ThLehmann/XSensor/PCB/XSensAdapt/Variants/ProMini3Pin2.png

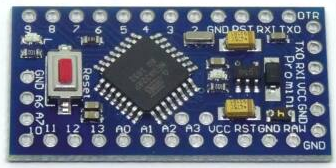
PCB/XSensAdapt/Variants/ProMini3Pin2.png
