ThLehmann/XSensor/PCB/XSensAdapt/Variants/ProMini3Pin.png

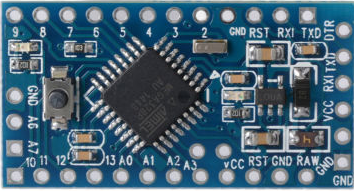
PCB/XSensAdapt/Variants/ProMini3Pin.png
