ThLehmann/XSensor/PCB/XSensAdapt/Variants/ProMini0Pin2.png

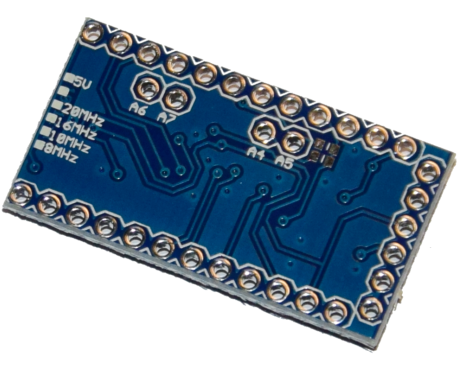
PCB/XSensAdapt/Variants/ProMini0Pin2.png
