ThLehmann/XSensor/PCB/XSensAdapt/Variants/ProMini0Pin.png

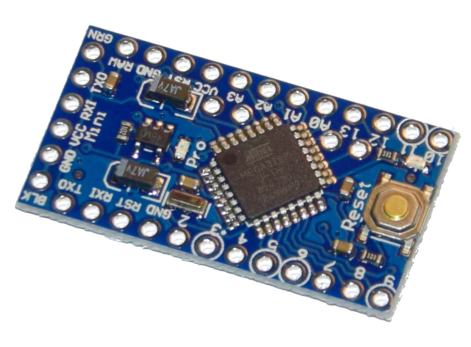
PCB/XSensAdapt/Variants/ProMini0Pin.png
