ThLehmann/XSensor/PCB/XSensAdapt/Variants/ProMini5Pin.png

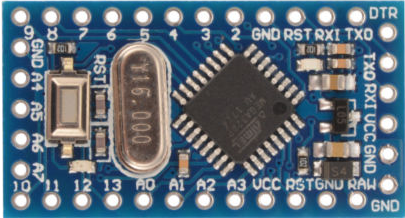
PCB/XSensAdapt/Variants/ProMini5Pin.png
