ThLehmann/XSensor/PCB/MUL-6S/MUL-6S.brd

## EAGLE design PCB/MUL-6S/MUL-6S.brd (2020-03-09)

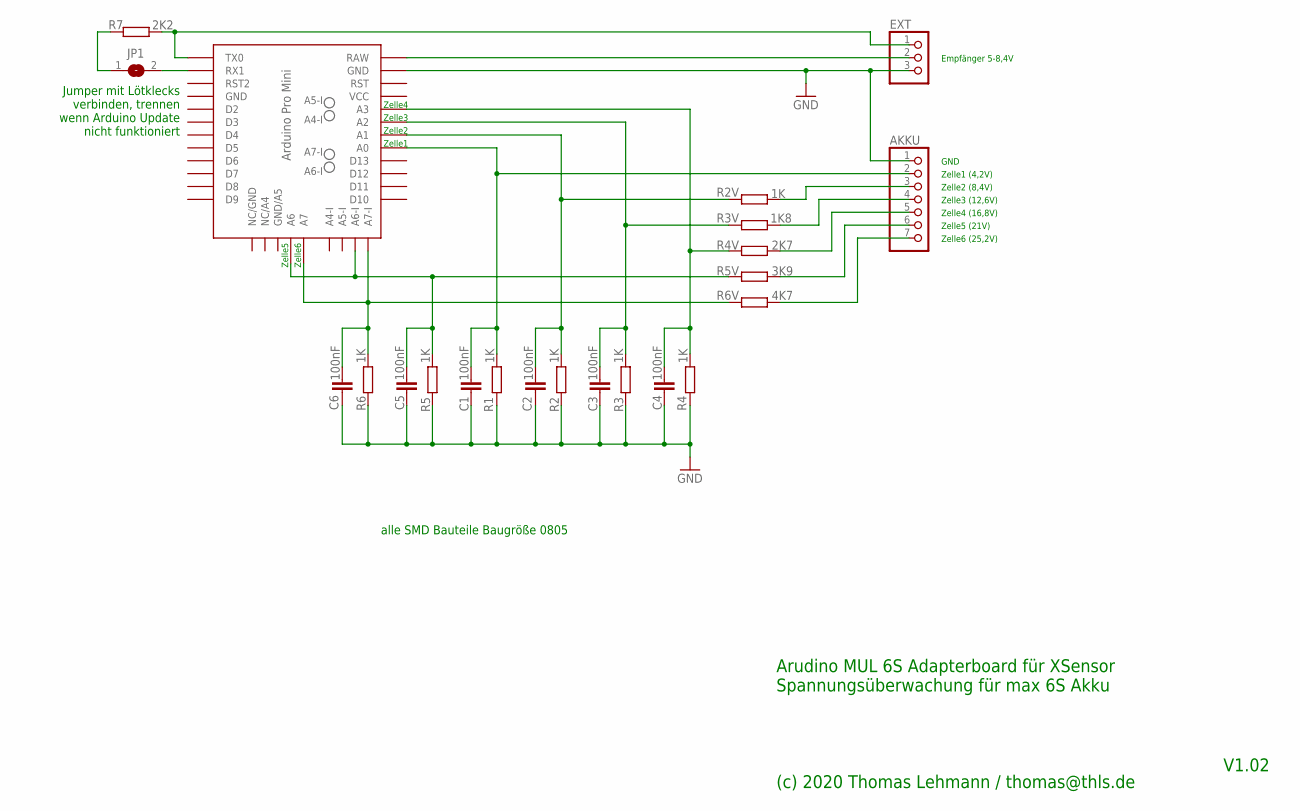
[picture p82: schematic MUL-6S.sch]

Parts:
AKKU: 1X07/90
C1, C2, C3, C4, C5, C6: 100nF; C0805K
EXT: 1X03/90
JP1: SJ
R1, R2, R2V, R3, R4, R5, R6: 1K; R0805
R3V: 1K8; R0805
R4V: 2K7; R0805
R5V: 3K9; R0805
R6V: 4K7; R0805
R7: 2K2; R0805
U$1: PRO-MINI-5PIN-KLPAD

Connections:
GND: AKKU.1, C1.2, C2.2, C3.2, C4.2, C5.2, C6.2, EXT.3, R1.2, R2.2, R3.2, R4.2, R5.2, R6.2, U$1.GND, U$1.GND1 (GND)
unnamed: C4.1, R4.1, R4V.1, U$1.A3
unnamed: EXT.2, U$1.RAW
unnamed: EXT.1, R7.2, U$1.TX0
unnamed: JP1.1, R7.1
unnamed: AKKU.3, R2V.2
unnamed: AKKU.4, R3V.2
unnamed: AKKU.5, R4V.2
unnamed: AKKU.6, R5V.2
unnamed: AKKU.7, R6V.2
unnamed: AKKU.2, C1.1, R1.1, U$1.A0
unnamed: C5.1, R5.1, R5V.1, U$1.A6, U$1.A6-I
unnamed: C6.1, R6.1, R6V.1, U$1.A7, U$1.A7-I
unnamed: JP1.2, U$1.RX1
unnamed: C2.1, R2.1, R2V.1, U$1.A1
unnamed: C3.1, R3.1, R3V.1, U$1.A2

Notes on the sheet:
Zelle1
Zelle2
Zelle3
Zelle4
Zelle5
Zelle6
Zelle1 (4,2V)
Zelle2 (8,4V)
Zelle3 (12,6V)
Zelle4 (16,8V)
Zelle5 (21V)
Zelle6 (25,2V)
GND
Empfänger 5-8,4V
Arudino MUL 6S Adapterboard für XSensor Spannungsüberwachung für max 6S Akku
(c) 2020 Thomas Lehmann / thomas@thls.de
V1.02
Jumper mit Lötklecks verbinden, trennen wenn Arduino Update nicht funktioniert
alle SMD Bauteile Baugröße 0805

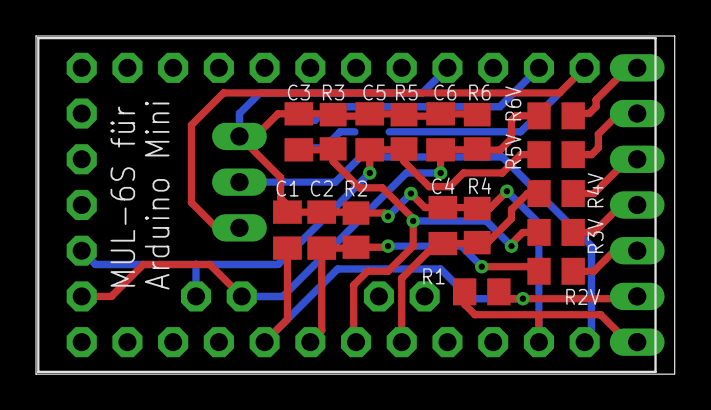
[picture p83: board MUL-6S.brd from above]

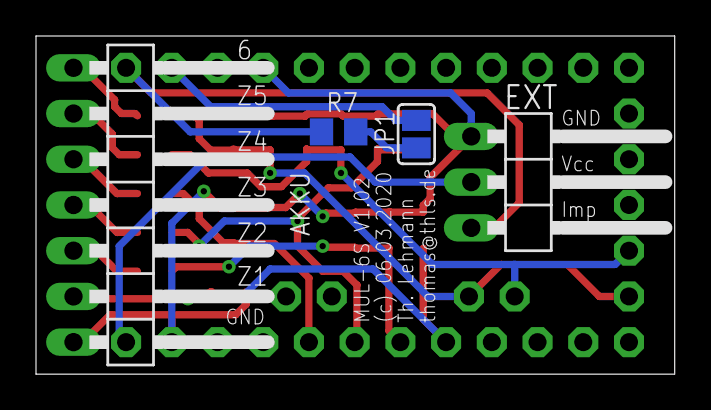
[picture p84: board MUL-6S.brd from below]

Board: 2 copper layers, 35.5 x 18.8 mm, 22 parts (2 on the bottom side), 16 nets.
