ThLehmann/XSensor/PCB/XSensAdapt/XSensorAdapter.brd

## EAGLE design PCB/XSensAdapt/XSensorAdapter.brd (2020-01-29)

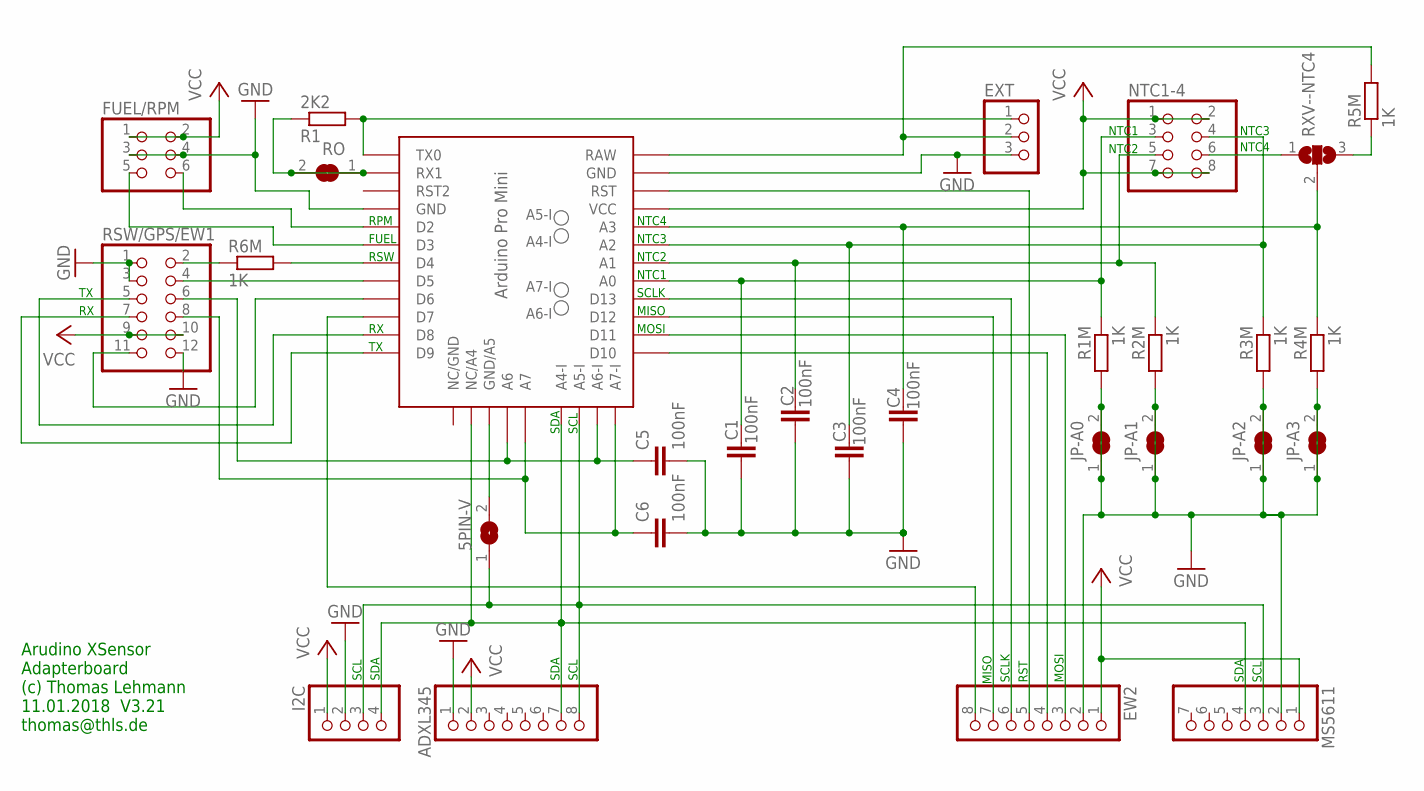
[picture p85: schematic XSensorAdapter.sch]

Parts:
5PIN-V: SJ
ADXL345: 1X08
C1, C2, C3, C4, C5, C6: 100nF; C2.5-2
EW2: 1X08
EXT: 1X03
FUEL/RPM: 2X03
I2C: 1X04
JP-A0, JP-A1, JP-A2, JP-A3: SJ
MS5611: 1X07
NTC1-4: 2X04
R1: 2K2; 0207/10
R1M, R2M, R3M, R4M, R5M, R6M: 1K; 0207/10
RO: SJ
RSW/GPS/EW1: 2X06
RXV--NTC4: SJ_2
U$1: PRO-MINI-5PINPRO-MINI-5PIN; PRO-MINI-5PIN

Connections:
GND: ADXL345.1, C1.2, C2.2, C3.2, C4.2, C5.2, C6.2, EW2.2, EXT.3, FUEL/RPM.3, FUEL/RPM.4, I2C.2, JP-A0.1, JP-A0.2, JP-A1.1, JP-A1.2, JP-A2.1, JP-A2.2, JP-A3.1, JP-A3.2, MS5611.2, R1M.2, R2M.2, R3M.2, R4M.2, RSW/GPS/EW1.1, RSW/GPS/EW1.3, RSW/GPS/EW1.12, U$1.GND, U$1.GND1 (GND)
unnamed: C4.1, R4M.1, RXV--NTC4.2, U$1.A3
unnamed: EXT.1, R1.2, U$1.TX0
unnamed: RSW/GPS/EW1.7, U$1.D9
unnamed: R5M.1, RXV--NTC4.3
unnamed: C5.1, RSW/GPS/EW1.6, U$1.A6, U$1.A6-I
unnamed: RSW/GPS/EW1.4, U$1.D5
unnamed: RSW/GPS/EW1.5, U$1.D8
unnamed: 5PIN-V.2, U$1.GND/A5
unnamed: C1.1, NTC1-4.3, R1M.1, U$1.A0
unnamed: FUEL/RPM.6, U$1.D2
unnamed: R6M.2, U$1.D4
unnamed: ADXL345.7, I2C.4, MS5611.4, U$1.A4-I, U$1.NC/A4
unnamed: FUEL/RPM.5, U$1.D3
unnamed: R6M.1, RSW/GPS/EW1.2
unnamed: C6.1, RSW/GPS/EW1.8, U$1.A7, U$1.A7-I
unnamed: C2.1, NTC1-4.5, R2M.1, U$1.A1
unnamed: C3.1, NTC1-4.4, R3M.1, U$1.A2
unnamed: EW2.6, U$1.D13
unnamed: EW2.7, U$1.D12
unnamed: EW2.3, U$1.D11
unnamed: EW2.4, U$1.D10
unnamed: EXT.2, R5M.2, U$1.RAW
unnamed: RSW/GPS/EW1.11, U$1.D6
unnamed: NTC1-4.6, RXV--NTC4.1
unnamed: EW2.5, U$1.RST
unnamed: EW2.8, U$1.D7
unnamed: 5PIN-V.1, ADXL345.8, I2C.3, MS5611.3, U$1.A5-I
unnamed: R1.1, RO.1, RO.2, U$1.RX1
VCC: ADXL345.2, EW2.1, FUEL/RPM.1, FUEL/RPM.2, I2C.1, MS5611.1, NTC1-4.1, NTC1-4.2, NTC1-4.7, NTC1-4.8, RSW/GPS/EW1.9, RSW/GPS/EW1.10, U$1.VCC

Notes on the sheet:
Arudino XSensor Adapterboard (c) Thomas Lehmann 11.01.2018 V3.21 thomas@thls.de
SDA
SCL
MOSI
MISO
SCLK
NTC1
NTC2
NTC3
NTC4
RPM
FUEL
RSW
RST

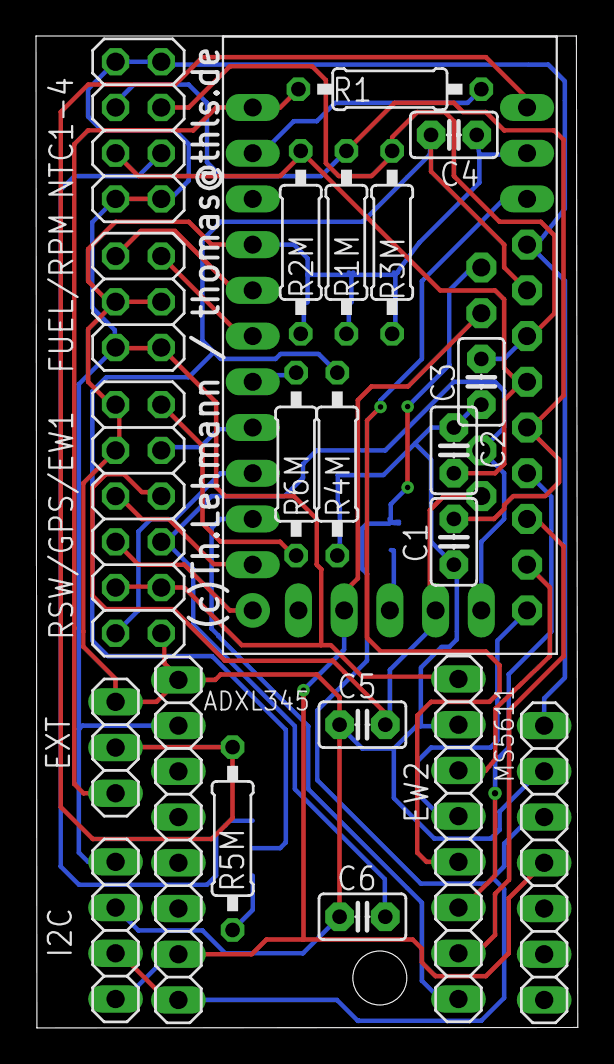
[picture p86: board XSensorAdapter.brd from above]

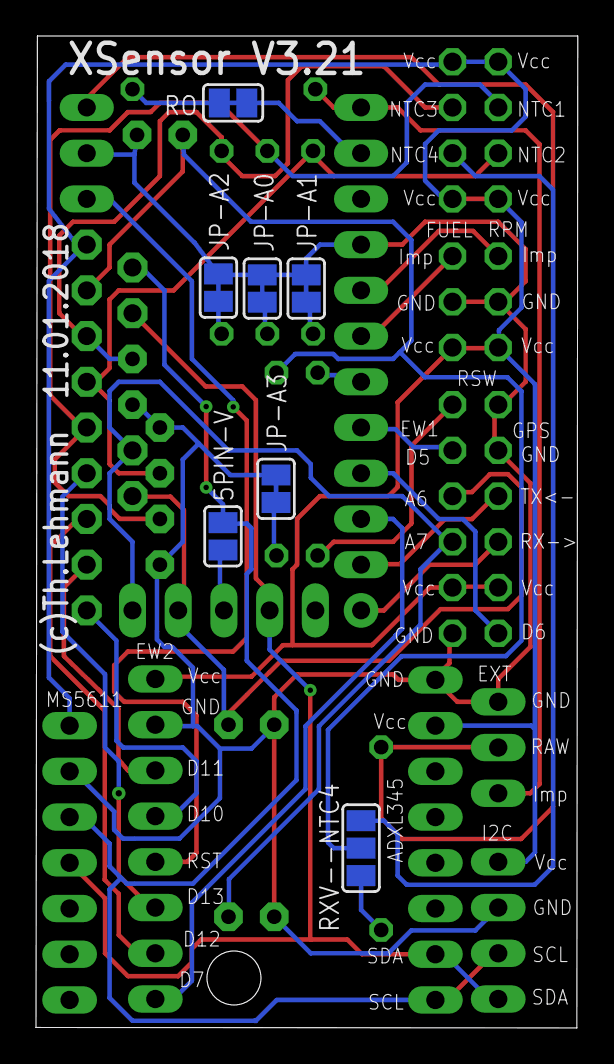
[picture p87: board XSensorAdapter.brd from below]

Board: 2 copper layers, 30.1 x 55.1 mm, 29 parts (7 on the bottom side), 30 nets.
