ThLehmann/XSensor/XSensor/JetiExProtocol.h

/* 
  Jeti Sensor EX Telemetry C++ Library
  
  JetiExProtocol - EX protocol implementation
  --------------------------------------------------------------------
  
  Copyright (C) 2015 Bernd Wokoeck
  
  Version history:
  0.90   11/22/2015  created
  0.95   12/23/2015  Refactoring
  0.96   02/21/2016  comPort number as parameter for Teensy
                     sensor device id as optional parameter (SetDeviceId())
  0.99   06/05/2016  increase max number of sensors to 32
  1.00   01/29/2017  Some refactoring:
                     - Bugixes for Jetibox keys and morse alarms (Thanks to Ingmar !)
                     - Optimized half duplex control for AVR CPUs in JetiExHardwareSerialInt class (for improved Jetibox key handling)
                     - Reduced size of serial transmit buffer (128-->64 words) 
                     - Changed bitrates for serial communication for AVR CPUs (9600-->9800 bps)
                     - EX encryption removed, as a consequence: new manufacturer ID: 0xA409
                       *** Telemetry setup in transmitter must be reconfigured (telemetry reset) ***
                     - Delay at startup increased (to give receiver more init time)
                     - New HandleMenu() function in JetiexSensor.ini (including more alarm test)
                     - JETI_DEBUG and BLOCKING_MODE removed (cleanup)
  1.02   03/28/2017  New sensor memory management. Sensor data can be located in PROGMEM
  1.04   07/18/2017  dynamic sensor de-/activation
         21.12.2ß017 Th. Lehmann, some modifications
                     - discard _sensorMapper[], Sensors adressed by SensIdx (ArrIdx), sensor Id in SensorArray free useable
                     - discard m_activeSeonsors[]
                     - Sensor acttivation by bitmask on startup function
                     - removed JetiBoxExit() and JetiBoxAlarm(), SetDeviceId()
                     

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
**************************************************************/
#ifndef JETIEXPROTOCOL_H
#define JETIEXPROTOCOL_H

#if ARDUINO >= 100
 #include <Arduino.h>
#else
 #include <WProgram.h>
#endif

#include "JetiExSerial.h"
#include <new.h>

// Definition of Jeti sensor (aka "Equipment")

// constant data
////////////////
typedef struct /*_JetiSensorConst*/
{
  uint8_t id;
  char    text[14+1];
  char    unit[4+1];
  uint8_t dataType;
  uint8_t precision;
}JetiSensorConst;
typedef const JetiSensorConst JETISENSOR_CONST; 


// dynamic sensor data
//////////////////////
class JetiValue
{
  friend class JetiSensor;
  friend class JetiExProtocol;
public:

  JetiValue() : m_value( -1 ) {}

protected:
  // value
  int32_t m_value;
};

// complete data for a sensor to fill ex frame buffer
/////////////////////////////////////////////////////
class JetiExProtocol;
class JetiSensor
{
public:
  // Jeti data types
  enum enDataType
  {
    TYPE_6b   = 0, // int6_t  Data type 6b (-31 �31)
    TYPE_14b  = 1, // int14_t Data type 14b (-8191 �8191)
    TYPE_22b  = 4, // int22_t Data type 22b (-2097151 �2097151)
    TYPE_DT   = 5, // int22_t Special data type � time and date
    TYPE_30b  = 8, // int30_t Data type 30b (-536870911 �536870911) 
    TYPE_GPS  = 9, // int30_t Special data type � GPS coordinates:  lo/hi minute - lo/hi degree. 
  }
  EN_DATA_TYPE;

  JetiSensor( int arrIdx, JetiExProtocol * pProtocol );

  // sensor id
  uint8_t m_id;

  // value
  int32_t m_value;

  // value
  uint8_t m_bActive;

  // label/description of value
  uint8_t m_label[ 20 ];
  uint8_t m_textLen;
  uint8_t m_unitLen;

  // format
  uint8_t  m_dataType;
  uint8_t  m_precision; 
  uint8_t  m_bufLen;

  // helpers
  void    copyLabel( const uint8_t * text, const uint8_t * unit,  uint8_t * label, int label_size, uint8_t * textLen, uint8_t * unitLen );
  uint8_t jetiCopyLabel( uint8_t * exbuf, uint8_t n );
  uint8_t jetiEncodeValue( uint8_t * exbuf, uint8_t n );
};

// Definition of Jeti EX protocol
/////////////////////////////////
class JetiExProtocol
{
  friend class JetiSensor;
public:
  enum enLineNo
  {
    LINE1 = 0,
    LINE2 = 1
  };

  enum enJetiboxKey
  {
    DOWN  = 0xb0,
    UP    = 0xd0,
    LEFT  = 0x70,
    RIGHT = 0xe0,
  };

  enum enComPort
  {
    DEFAULTPORT = 0x00,
    SERIAL1     = 0x01,
    SERIAL2     = 0x02,
    SERIAL3     = 0x03,
  };

  void Start( const char * name, uint8_t SensNb, JETISENSOR_CONST * pSensorArray, uint8_t SensCnt, uint8_t *SensActivMsk, enComPort comPort = DEFAULTPORT );   // call once in setup(), comPort: 0=Default, Teensy: 1..3
  void Tim10mS( void );

  void SetSensorValue( uint8_t id, int32_t value );
  void SetSensorValueGPS( uint8_t id, bool bLongitude, float value );
  void SetSensorValueDate( uint8_t id, uint8_t day, uint8_t month, uint16_t year );
  void SetSensorValueTime( uint8_t id, uint8_t hour, uint8_t minute, uint8_t second );
  void SetJetiboxText( enLineNo lineNo, const char* text );
//  void SetJetiboxExit() { m_bExitNav = true; };
//  void SetJetiAlarm( char alarmChar ) { m_alarmChar = alarmChar; }

  boolean GetJetiboxKey( uint8_t *Key );

protected:
  uint8_t *SensorActivMsk;    // BIT je aktiven Sensor
  
  void SendExFrame( uint8_t frameCnt );
  void SendJetiboxTextFrame();
//  void SendJetiboxExit();
//  void SendJetiAlarm( char code );

  // EX frame control
  uint16_t           TmoDoSend;
    #define TMO_DO_SEND     (150/TIM_BASE)    // alle 150mS einen Frame senden
  uint8_t            m_frameCnt;          

  // sensor name
  const char        *m_name;
  uint8_t            m_nameLen;
  uint8_t            m_SensNb;                      // 0-n, 1-n wenn mehrere Sensoren eingesetzt werden

  // sensor array
  JETISENSOR_CONST * m_pSensorsConst;               // array to constant sensor definitions
  JetiValue        * m_pValues;                     // sensor value array, same order as constant data array
  uint8_t            m_nSensors;                    // number of sensors
  uint8_t            m_sensorIdx;                   // current index to sensor array to send value
  uint8_t            m_dictIdx;                     // current index to sensor array to send sensor dictionary

  // serial interface
  JetiExSerial     * m_pSerial;

  // EX frame buffer
  uint8_t m_exBuffer[32]; 

  // Jetibox text buffer
  char m_textBuffer[32]; 

  // alarm request
//  char m_alarmChar;

  // request exit sequence for jetibox navigation
//  bool m_bExitNav;

  //crypt and crc
  enum
  {
    // Jeti Duplex EX Ids: Manufacturer and device
    MANUFACTURER_ID_LOW = 0x09, // 0xA409 (Jeti recommended range for 3rd party sensors is 0xA400 � 0xA41F)
    MANUFACTURER_ID_HI  = 0xA4,
    DEVICE_ID_LOW       = 0x11, // random number: 0x2311
    DEVICE_ID_HI        = 0x23,
    POLY                = 0x07, // constant for for "crypt"
  };
  uint8_t update_crc (uint8_t crc, uint8_t crc_seed);
  uint8_t jeti_crc8 (uint8_t *exbuf, unsigned char framelen);
};

/*
struct
  {
  uint8_t Stx;                // 0x7e
  uint8_t IdEx;               // 0x2f
  uint8_t DataLen     : 6;    // # Bytes folgend
  uint8_t Type        : 2;    // Pakret Type, 1= Data / 0 = Text Protokoll
  uint8_t ManIdLo;            // Manufacturer ID, little endian
  uint8_t ManIdHi;
  uint8_t DevIdLo;            // Device ID, little endian
  uint8_t DevIdHi;
  uint8_t Res;                // 0x00
  uint8_t Data[29];
  };
  
*/


#endif // JETIEXPROTOCOL_H
