ThLehmann/XSensor/(commit log)

2020-01-29 intial commit
    [MUL-6S.brd, MUL-6S.sch, XSensorAdapter.brd, XSensorAdapter.sch, XSensor_PINs_Menue.xlsx]
2020-01-29 Readme ergänzt Src in XSensor geändet, Arduino IDE verlangt Namen
2020-01-29 ÜSchrift Sensoren
2020-01-29 3. Boardvariante (Bild) ergänzt
2020-02-25 V2_0_2 MUL-6S PCB
2020-03-09 Zelle 1 war falsch angeschlossen
    [MUL-6S.brd, MUL-6S.sch]
